johnnyr/Mini-Rambo/board/Project Outputs for Mini-Rambo/ExportIDF/IDFReport_Mini-Rambo.html

Altium customize

# IDF File Translation Report

Date: | | 11/29/2016
Time: | | 9:40:23 PM
Elapsed Time: | | 00:00:00
PCB Filename | : | C:\Users\Johnny-x-9c\Documents\Projects\Mini-Rambo\board\Mini-Rambo.PcbDoc
IDF Board Filename | : | C:\Users\Johnny-x-9c\Documents\Projects\Mini-Rambo\board\Project Outputs for Mini-Rambo\ExportIDF\Mini-Rambo.brd
IDF Library Filename | : | C:\Users\Johnny-x-9c\Documents\Projects\Mini-Rambo\board\Project Outputs for Mini-Rambo\ExportIDF\Mini-Rambo.pro

Errors

Back to top

Warnings

Back to top

Save Warnings

Back to top

Save Errors

Back to top

Export Warnings

Back to top

Export Errors

Back to top
