johnnyr/Mini-Rambo/board/Project Outputs for Mini-Rambo/Report Board Stack/Mini-Rambo.xls

Board Stack Report
Stack Up |  | Layer Stack
Layer | Board Layer Stack | Name | Material | Thickness | Constant
1 |  | Top Paste
2 |  | Top Overlay
3 |  | Top Solder | Solder Resist | 0.47mil | 3.5
4 |  | Top | Copper | 2.76mil
5 |  | Dielectric 1 | FR-4 | 21.65mil | 4.3
6 |  | GND | Copper | 1.38mil
7 |  | Dielectric 2 | FR-4 | 10.24mil | 4.3
8 |  | Supply | Copper | 1.38mil
9 |  | Dielectric 3 | FR-4 | 21.65mil | 4.3
10 |  | Bottom | Copper | 2.76mil
11 |  | Bottom Solder | Solder Resist | 0.47mil | 3.5
12 |  | Bottom Overlay
13 |  | Bottom Paste
 | Height : 62.76mil
