johnnyr/Mini-Rambo/(threads)

Thread 1 (2016-11-02):

missing pdf of schematic for einy rambo

tonokip, 2016-11-02:

tonokip, 2016-11-15:
Found it. I was looking in the wrong folders.
This is the location:
https://github.com/johnnyr/Mini-Rambo/tree/2.0/board/ProjectOutputs

Closed 2016-11-15.

Thread 2 (2016-12-23):

Breakout unused analog pins

madhunm, 2016-12-23:
@johnnyr

Can you please breakout the unused analog pins in miniRambo V2.0 without adding additional pullups?

Currently, using a PT100 with amplifier is a nightmare because of the pullups on T0, T1 and T2.

Thanks,
Madhu.

johnnyr, 2016-12-23:
Good request. We will try.

Johnny Russell
UltiMachine

On Dec 23, 2016 10:17 AM, "madhunm" <notifications@github.com> wrote:

@johnnyr <https://github.com/johnnyr>

Can you please breakout the unused analog pins in miniRambo V2.0 without
adding additional pullups?

Currently, using a PT100 with amplifier is a nightmare because of the
pullups on T0, T1 and T2.

Thanks,
Madhu.

—
You are receiving this because you were mentioned.
Reply to this email directly, view it on GitHub
<https://github.com/johnnyr/Mini-Rambo/issues/2>, or mute the thread
<https://github.com/notifications/unsubscribe-auth/AAMeGtOJ-K5ZzMR57OcACBAbiiujSsNHks5rK_QFgaJpZM4LU7NT>
.

Thread 3 (2017-01-03):

PT100 thermal sensor without amp

madhunm, 2017-01-03:
When we use PT100 sensor without amp; set the thermistor table to 147 in Marlin, the temperature offsets are about 15 to 20 degrees C.

Changing the RUp in the PtLine equations from 4700 to 5025 seems to have addressed this issue on the low end of the scale.

However, at the high end of the scale, compared to a PT100 with an amp and using table 20, the difference becomes about 30 degrees C

Is this an issue with the hardware or Marlin?

Thread 4 (2017-05-14):

Atmega2560 pins 17 and 16 switched on datasheet.

Gadzook8, 2017-05-14:
I think pins 17 and 16 are labeled wrong in the Mini-Rambo.pdf (https://github.com/johnnyr/Mini-Rambo/blob/1.3a/board/Project%20Outputs%20for%20Mini-Rambo/Mini-Rambo.PDF). According pins_arduino.h (https://github.com/ultimachine/RAMBo/blob/master/ArduinoAddons/Arduino_1.x.x/rambo/variants/standard/pins_arduino.h) pin 16 should be labeled TX2, and pin 17 should be labeled RX2.

leptun, 2019-04-01:
Can confirm. Spent a couple of weeks not knowing why they didn't work. Thank you soooooo much for pointing it out.

Thread 5 (2017-07-10):

Document pinout

probonopd, 2017-07-10:
Please document the pinout of all of the headers.

**MiniRambo1.3a**
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

urbaniak, 2017-09-24:
That's the only one schema I've found describing the p3 (yellow) connector, looks great!

Got one question - does the RX/TX pins there are the same serial interface as the one available via usb? I want to connect octopi on raspberry (zero maybe) directly to the board (not via usb, which causes board reset when connecting).

probonopd, 2017-09-24:
No, these are not the same pins as USB. According to the Ultimachine technical support, the RX/TX connected to USB is only available as test points on the back side of the board.

Thread 7 (2018-05-08):

I want to change THERMISTOR PIN 0 to PIN 1 in RAMBo 1.3 Firmware

martinalejo93, 2018-05-08:
Hello!

First of all, sorry for my english.

I'm triying to change by code, the Thermistor OUT0 to Thermistor OUT1 but i' don't know where I should do the modification, I've downloaded the firmware MARLIN.ino and i'm looking for the pins assignment but i can't find it

Thread 8 (2019-01-21):

Safety Problem with thermistor circuit

RetireeJay46, 2019-01-21:
The clamping circuit for thermistor inputs uses a zener diode to theoretically limit the positive voltage excursion at the ATMega input to just a shade over 5.0V.  However, there are two problems with the circuit: (1) the current through the 4.7V zener, 0.73mA, is not sufficient to put the zener fully into its rated clamping voltage.  In practice, one user has seen 4.4V.  This was solved by increasing the current to about 3mA, well above the "knee" for his particular zener.
(2) Even with sufficient current, some zeners with this part number will be as low as 4.4V due to manufacturing tolerances.
The problem is this:  In either of the above scenarios, the analog voltage at the ATMega input is constrained to slightly less than 5V (note that the clamping diode is operating at a very low current, so its voltage drop added to the zener voltage is less than the canonical "0.6V").  If the input voltage at the ATMega is not allowed to go all the way up to VCC of 5V, then the A/D conversion will never return a full-scale reading.  But if (when) the thermistor leads break, the firmware requires a full-scale reading in order to detect the break and shut down the associated heater.  At room temperature of 20C the input voltage is 4.819V, and increasing slowly; 0C yields 4.930.  The open-circuit voltage should always, unconditionally, be allowed to go above 4.930 regardless of zener tolerance and other part tolerances.

Failure to trigger the firmware shutdown is a fire hazard.

Thread 9 (2019-04-01):

Test point markings are reversed for MAX endstops

leptun, 2019-04-01:
As the title says, the text does not match the traces on the board

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

If you zoom in on the lower right area you can see the following:
XMAX (text) -> YMAX (pin)
YMAX -> ZMAX
ZMAX -> probably XMAX, can't be seen in the picture but is most likely XMAX
